mitra42/frugal-iot-hw-sensor/claude-tools/layout/out/render_bottom.png

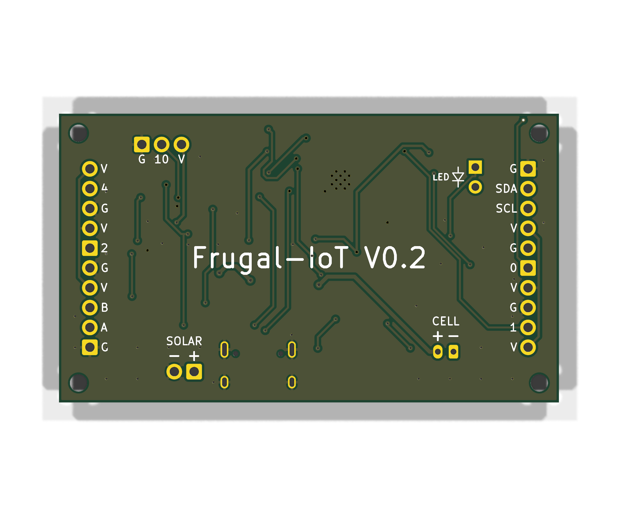
claude-tools/layout/out/render_bottom.png
