mitra42/frugal-iot-hw-sensor/claude-tools/layout/out/render_top.png

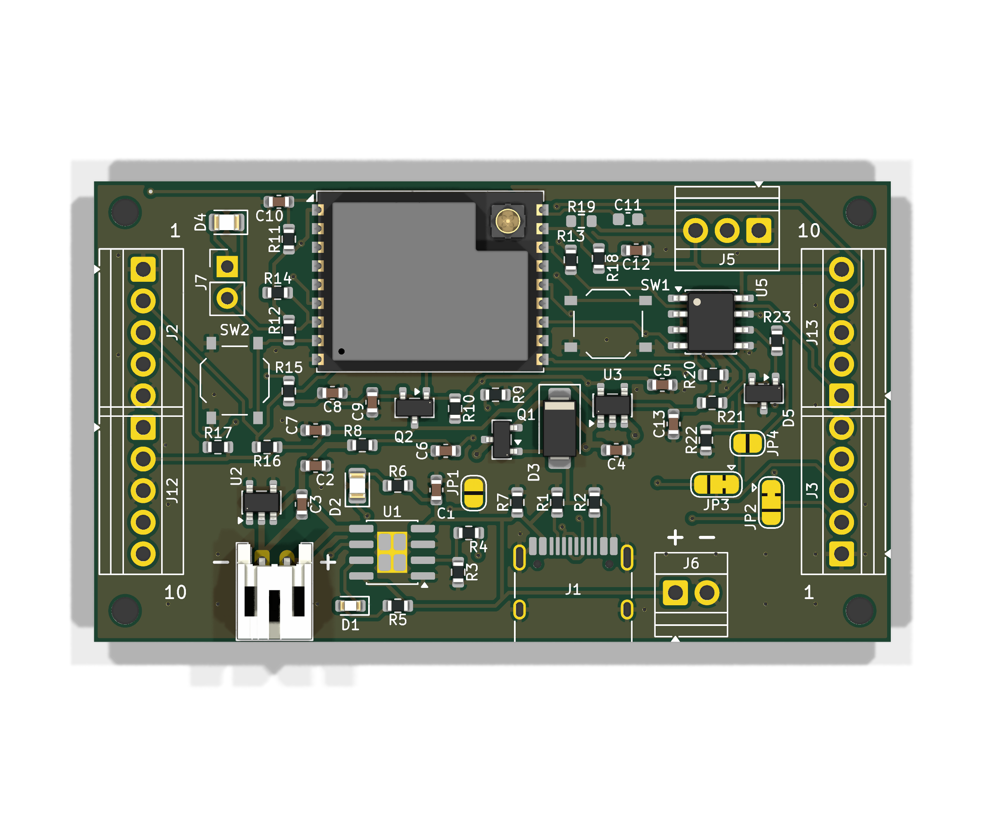
claude-tools/layout/out/render_top.png
