mitra42/frugal-iot-hw-sensor/COST-ESTIMATE.txt

Columns (part table):
  Type    Basic   = JLCPCB Basic part, permanently on a machine feeder: no feeder fee (Economic).
          PrefExt = 'Preferred Extended': Extended, but exempt from the feeder fee on Economic PCBA.
          Ext     = Extended: $3.07 feeder-loading fee once per part number per order (Economic).
  /brd    quantity per board.
  buy@N   quantity JLCPCB buys for N boards = max(/brd x N + JLCPCB's attrition allowance for that part,
          JLCPCB's minimum order for that part). E.g. a 0603 resistor at 10 boards: 1 x 10 + 10 = 20.
  $@N     buy@N x unit price at that quantity's price tier.

Refs                       Value                  LCSC       Type    /brd buy@10    $@10 buy@100   $@100
C1,C2,C4,C5,C8             10uF                   C19702     Basic      5     60    1.27     510    8.31
C3,C6,C9,C12,C13           100nF                  C14663     Basic      5     60    0.49     510    3.21
C7,C10                     1uF                    C15849     Basic      2     30    0.44     210    3.07
D1                         KT-0603R               C2286      Basic      1     20    0.15     110    0.85
D2,D4                      KT-0805G               C2297      Basic      2     30    0.49     210    3.44
D3                         SS34                   C8678      Basic      1     18    0.63     108    3.79
D5                         PSM712-LF-T7           C32677     Basic      1     11    3.79     101   27.57
J1                         TYPE-C-31-M-12         C165948    Ext        1     10    1.87     100   14.78
J2,J3,J12,J13              XY308-2.54-5P          C915914    Ext        4     40   18.21     400  159.84
J4                         S2B-PH-K-S             C173752    Ext        1     10    0.40     100    3.97
J6                         XY308-2.54-2P          C557685    Ext        1     10    2.48     100   19.54
Q1,Q2                      AO3401A                C15127     Basic      2     24    2.30     204   14.12
R1,R2                      5.1k                   C23186     Basic      2     30    0.04     210    0.32
R3,R4,R16-R18              4.7k                   C23162     Basic      5     60    0.17     510    1.43
R5,R6,R15                  1k                     C21190     Basic      3     40    0.07     310    0.53
R7,R10                     100k                   C25803     Basic      2     30    0.09     210    0.65
R8,R9                      1M                     C22935     Basic      2     30    0.05     210    0.38
R11-R14,R20                10k                    C25804     Basic      5     60    0.11     510    0.92
R21,R22                    680R                   C23228     Basic      2     30    0.06     210    0.44
R23                        120R                   C22787     Basic      1     20    0.04     110    0.21
SW1,SW2                    TS-1187A-B-A-B         C318884    Basic      2     28    0.58     208    3.33
U1                         TP4056                 C16581     PrefExt    1     10    1.86     100   14.69
U2                         XB5353A                C80628     Ext        1     12    1.06     102    7.12
U3                         ME6211C33M5G-N         C82942     Ext        1     12    0.76     102    5.26
U4                         ESP32-C3-WROOM-02U-N4  C2926676   Ext        1     10   28.41     100  223.38
U5                         SP3485EN-L/TR          C8963      Basic      1     10    2.64     100   17.63

Per board: 152 SMT joints, 24 through-hole joints, 26 part numbers (7 Extended with fee).

                                             10 Economic 100 Economic, panelised
Setup + stencil + confirm                         $10.16                  $18.37
SMT joints                                         $2.43                  $24.32
Through-hole joints (manual)                       $7.52                  $42.94
Feeder loading                                    $21.49                  $21.49
X-ray (module)                                     $0.00                   $0.00
Fixture + packing                                  $0.00                   $0.00
Components                                        $68.48                 $538.77
Bare PCB (placeholder, see notes)                   $5.00                  $69.90
TOTAL (excl. shipping)                           $115.09                 $715.79
Per board                                         $11.51                   $7.16

Same, per board:
Setup + stencil + confirm                          $1.02                   $0.18
SMT joints                                         $0.24                   $0.24
Through-hole joints (manual)                       $0.75                   $0.43
Feeder loading                                     $2.15                   $0.21
X-ray (module)                                     $0.00                   $0.00
Fixture + packing                                  $0.00                   $0.00
Components                                         $6.85                   $5.39
Bare PCB (placeholder, see notes)                   $0.50                   $0.70
Per board                                         $11.51                   $7.16

Notes:
  * Bare PCB is a placeholder until layout: the irrigation board's JLCPCB quote (100 x 80 mm), an upper bound
    for this 37 mm-high board. Replace with the real quote after layout.
  * Shipping, tax and import duty not included.
  * JLCPCB's FAQ says Economic PCBA above 30 pieces needs panelising; the panel fee ($8.21) is included
    in the 100-board column.
  * No X-ray: the ESP32-C3-WROOM-02U has castellated edge pads (X-ray applies to leadless/BGA parts).
  * Not fitted (DNP) parts cost nothing: J5, J7 and the sensor options R19, C11.
  * J4 (cell JST-PH) and J6 (5 V terminal) are fitted (D34): both Extended, hand-soldered. Together they add
    about $0.97 per board at 10 (mostly two $3.07 feeder fees) and $0.36 at 100.
  * JLCPCB's price page (22 Oct 2026) also lists 'pre-reflow soldering' at $0.016 per joint with no
    explanation; not included here. Check the quote for it.
  * RS485 / Modbus is fitted; leaving it off saves the amount shown at the end (no feeder fees: all Basic
    parts, and J3 is the same part number as J2/J12).

Extended (fee-bearing on Economic): C165948 C915914 C173752 C557685 C80628 C82942 C2926676

RS485 / Modbus (D29): included above. A board without Modbus can leave these off and save:
  parts: C13 100nF, D5 PSM712, J3 J3 RS485 1-5, R20 10k, R21,R22 680R, R23 120R, U5 SP3485EN
   10 boards: components $11.86 + assembly joints $1.16 + feeder fees $0.00 = $13.02  ($1.30 per board)
  100 boards: components $86.90 + assembly joints $11.56 + feeder fees $0.00 = $98.46  ($0.98 per board)
