mitra42/frugal-iot-hw-sensor/claude-tools/layout/out/placement.pdf

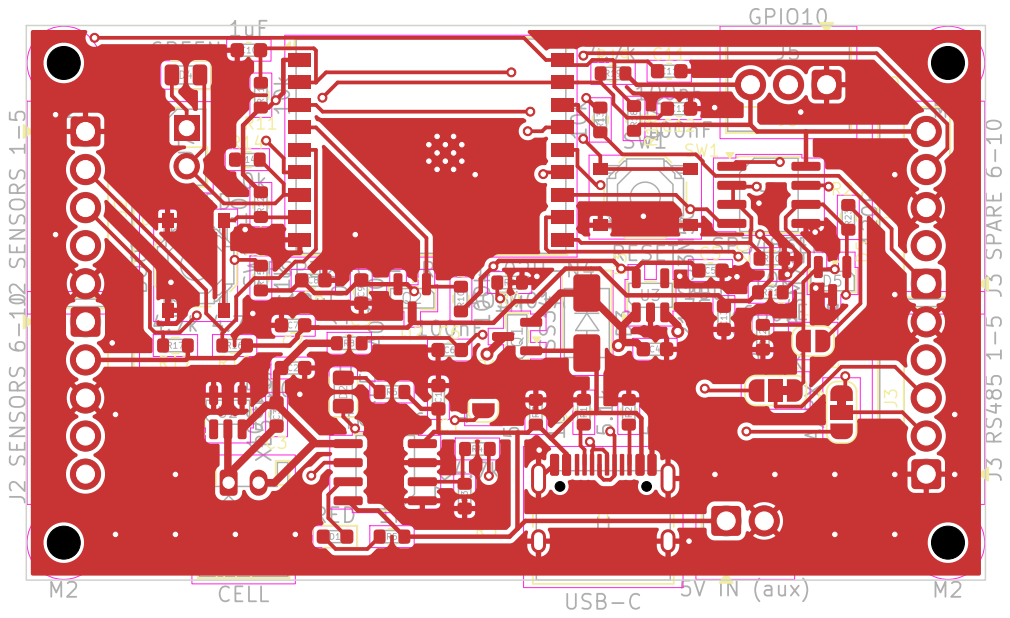
[picture p4: page 1]

Size: A4 | Rev:
KiCad E.D.A. 10.0.4 | Id: 1/1
