mitra42/frugal-iot-hw-sensor/claude-tools/layout/out/copper_bottom.pdf

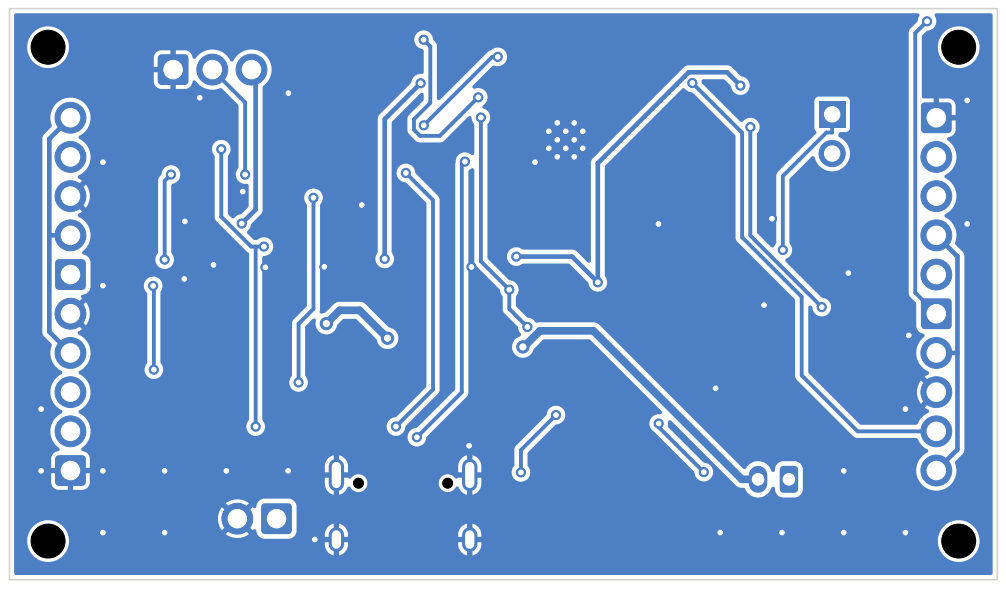
[picture p5: page 1]
