mitra42/frugal-iot-hw-sensor/claude-tools/layout/out/copper_top.pdf

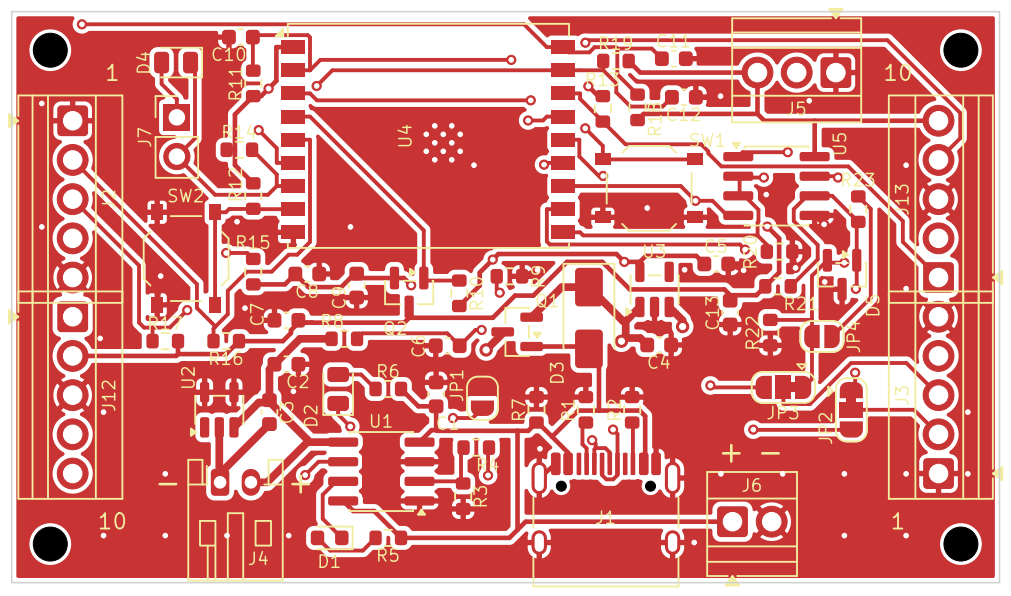
[picture p6: page 1]
