mitra42/frugal-iot-hw-sensor/(list of files, drawings)

Other design files:
claude-tools/layout/out/board.dsn
claude-tools/layout/out/board_r.dsn
