mitra42/frugal-iot-hw-sensor/frugal_iot_v02/frugal_iot_v02.kicad_pcb

## KiCad design frugal_iot_v02/frugal_iot_v02.kicad_pcb (2026-10-30)

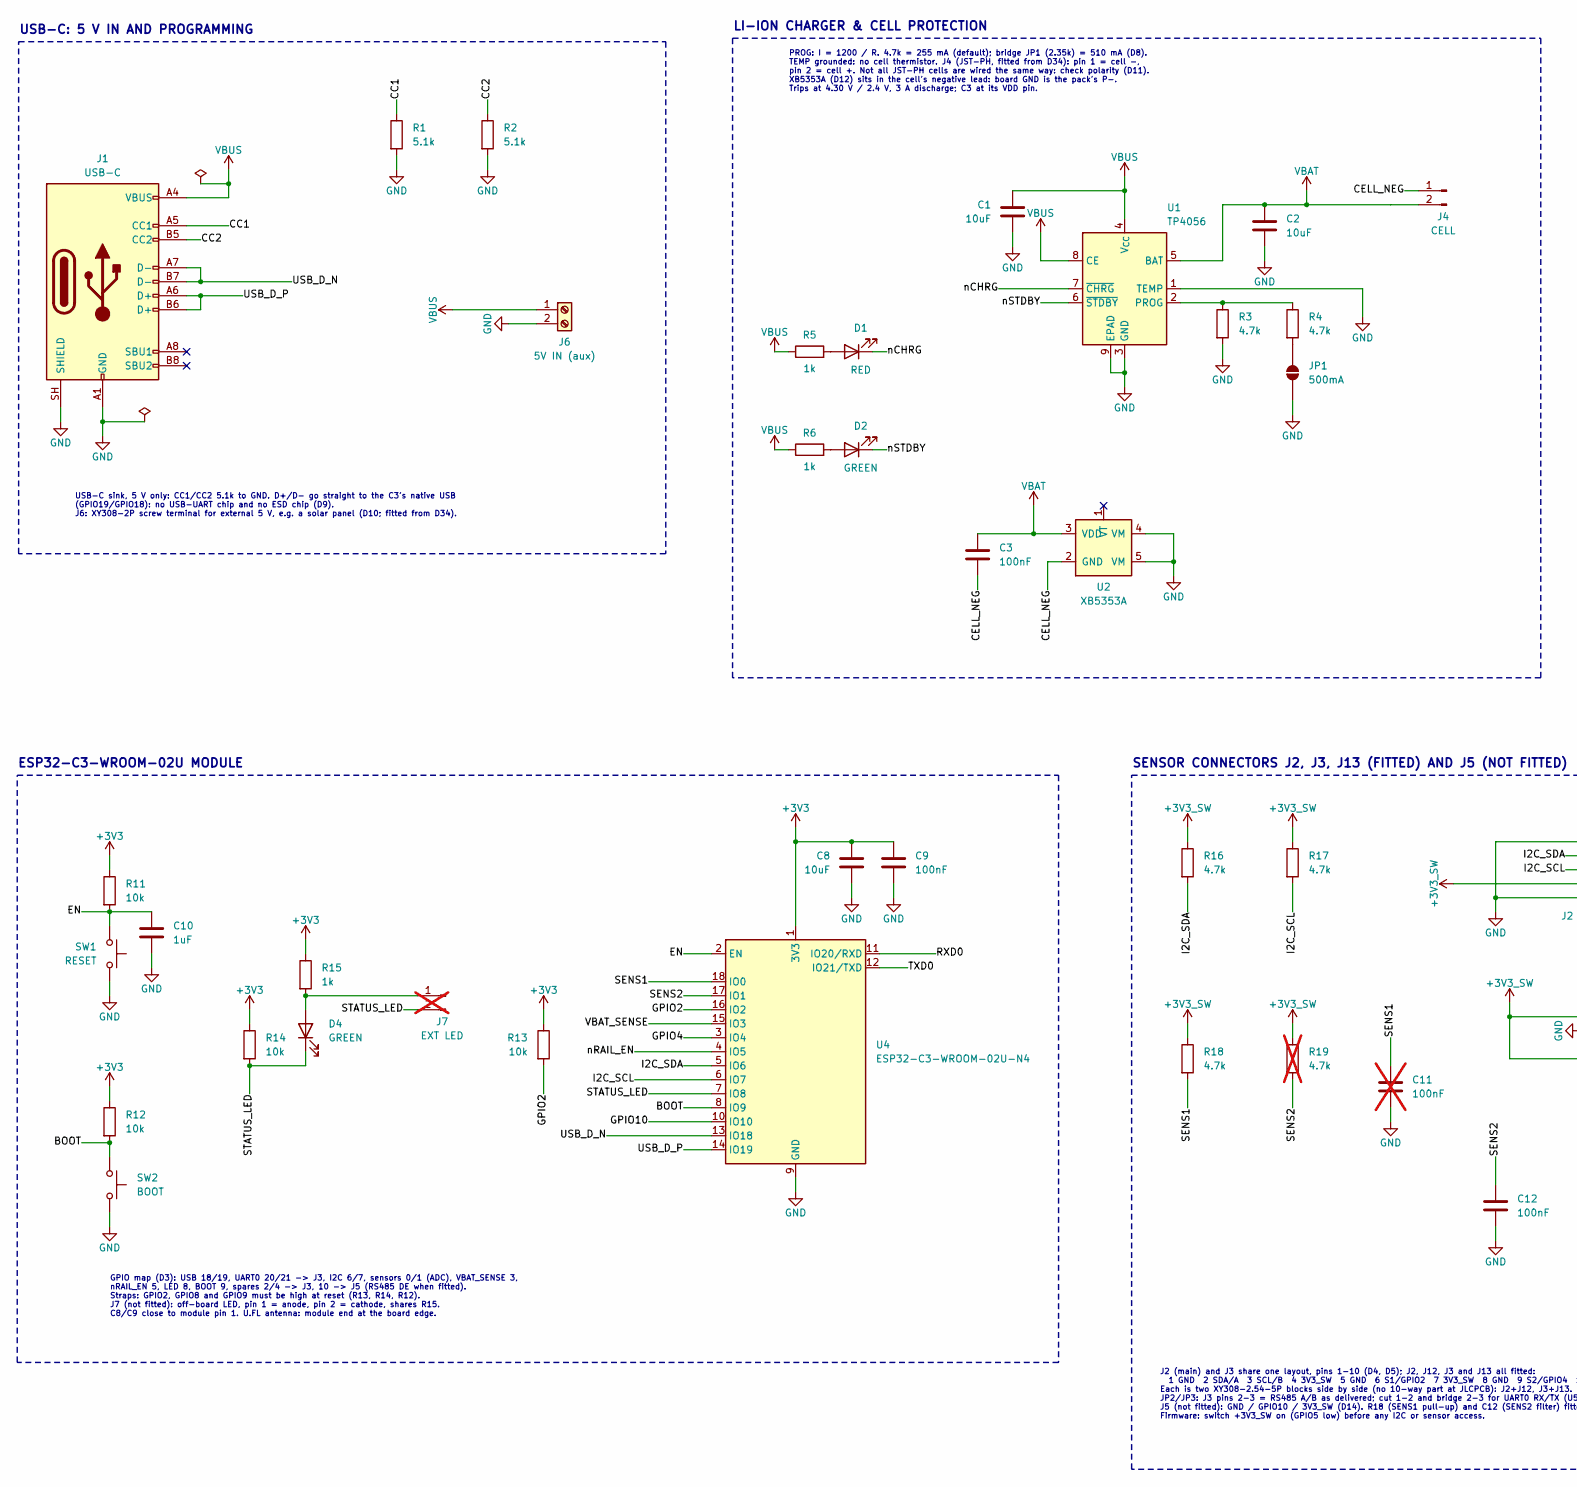
[picture p7: schematic frugal_iot_v02.kicad_sch, Frugal-IoT V0.2, part in row 1, column 1]

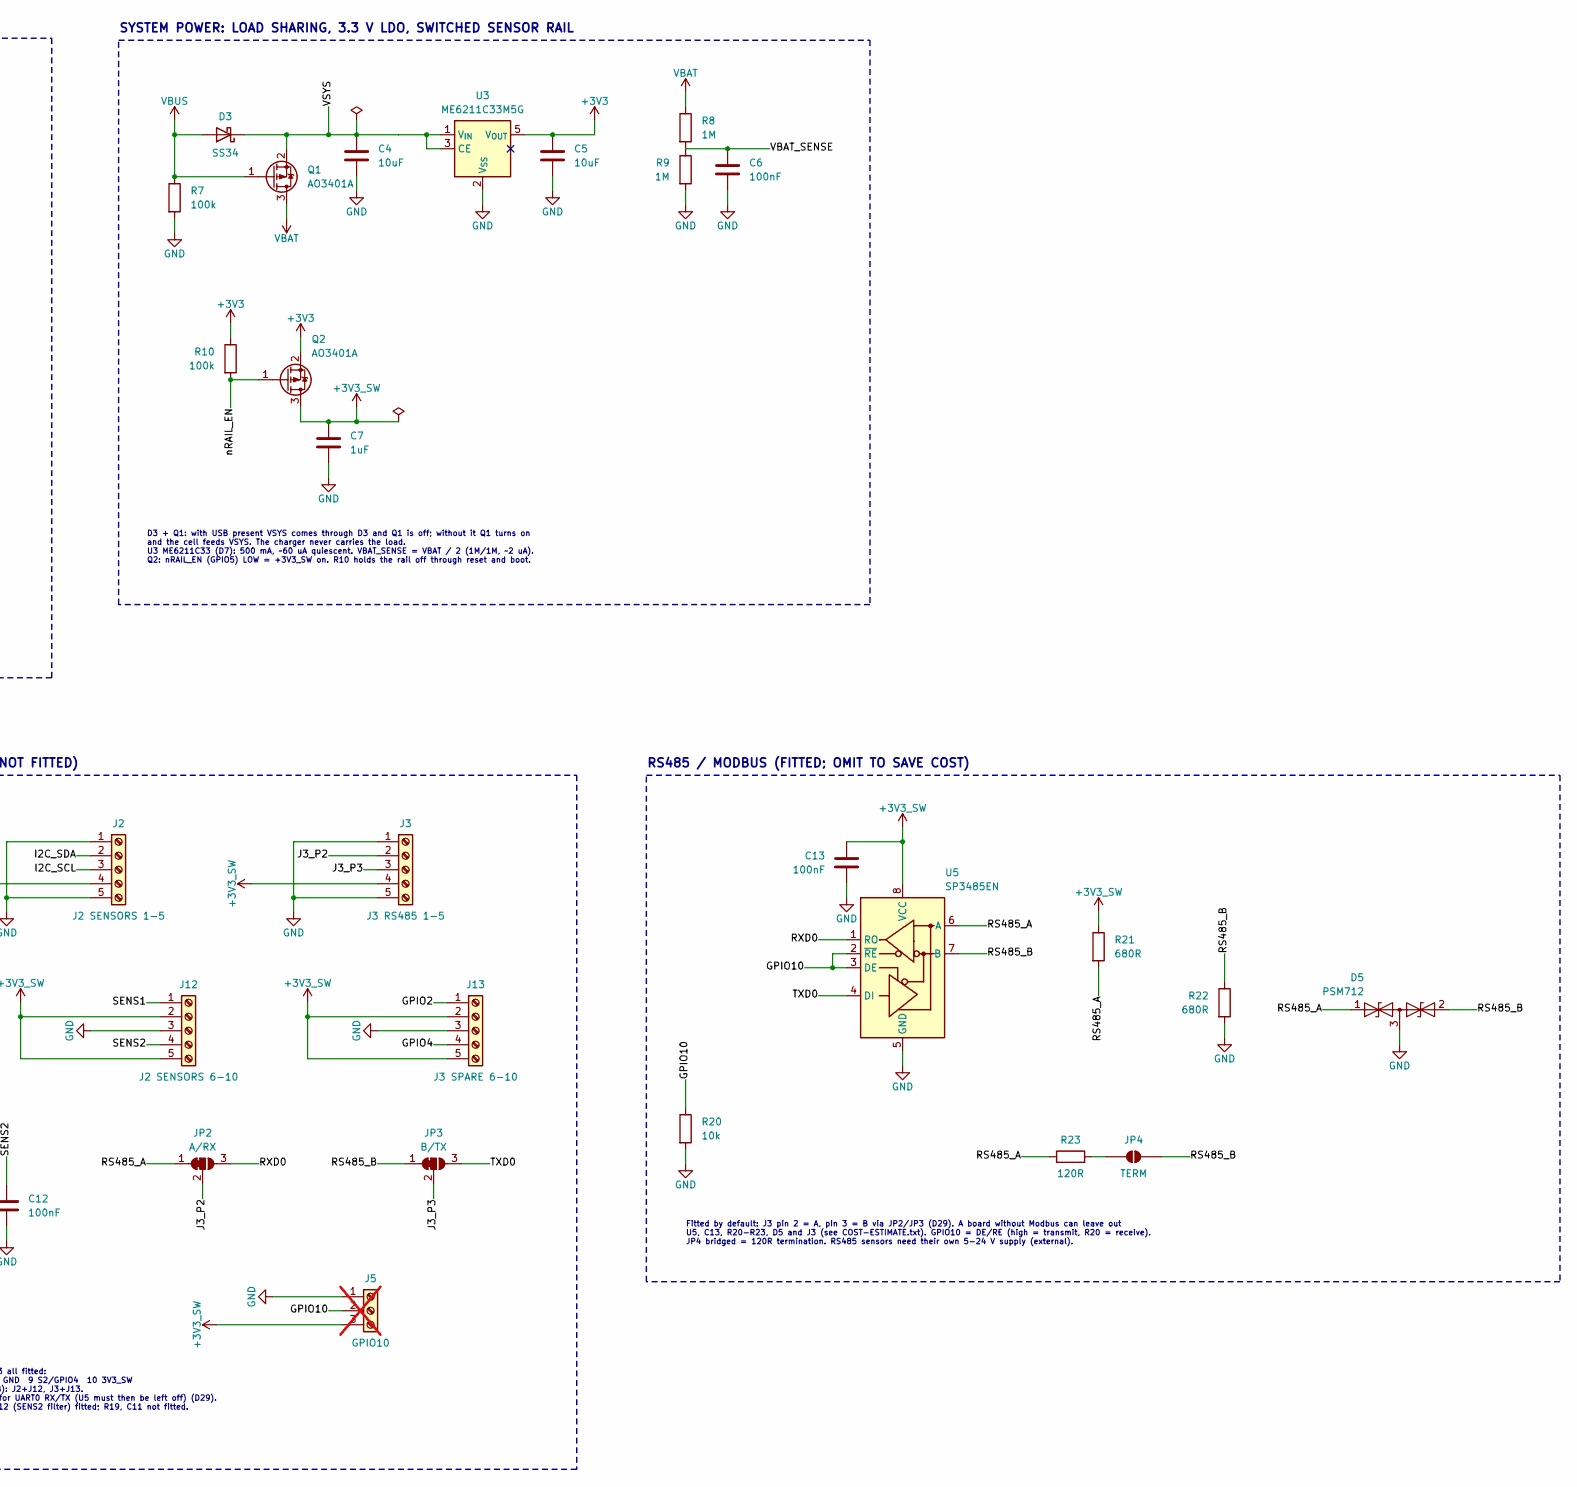
[picture p8: schematic frugal_iot_v02.kicad_sch, Frugal-IoT V0.2, part in row 1, column 2]

Parts:
C1, C2, C4, C5, C8: 10uF; C_0603_1608Metric; MPN 10uF; LCSC C19702
C3, C6, C9, C12, C13: 100nF; C_0603_1608Metric; MPN 100nF; LCSC C14663
C7, C10: 1uF; C_0603_1608Metric; MPN 1uF; LCSC C15849
C11: 100nF; C_0603_1608Metric; MPN 100nF; LCSC C14663; not fitted
D1: RED; LED_0603_1608Metric; MPN KT-0603R; LCSC C2286
D2, D4: GREEN; LED_0805_2012Metric; MPN KT-0805G; LCSC C2297
D3: SS34; D_SMA; MPN SS34; LCSC C8678
D5: PSM712; SOT-23; MPN PSM712-LF-T7; LCSC C32677
J1: USB-C; USB_C_Receptacle_HRO_TYPE-C-31-M-12; MPN TYPE-C-31-M-12; LCSC C165948
J2: J2 SENSORS 1-5; TerminalBlock_Xinya_XY308-2.54-5P_1x05_P2.54mm_Horizontal; MPN XY308-2.54-5P; LCSC C915914
J3: J3 RS485 1-5; TerminalBlock_Xinya_XY308-2.54-5P_1x05_P2.54mm_Horizontal; MPN XY308-2.54-5P; LCSC C915914
J4: CELL; JST_PH_S2B-PH-K_1x02_P2.00mm_Horizontal; MPN S2B-PH-K-S; LCSC C173752
J5: GPIO10; TerminalBlock_Xinya_XY308-2.54-3P_1x03_P2.54mm_Horizontal; MPN XY308-2.54-3P; LCSC C557686; not fitted
J6: 5V IN (aux); TerminalBlock_Xinya_XY308-2.54-2P_1x02_P2.54mm_Horizontal; MPN XY308-2.54-2P; LCSC C557685
J7: EXT LED; PinHeader_1x02_P2.54mm_Vertical; MPN EXT LED; not fitted
J12: J2 SENSORS 6-10; TerminalBlock_Xinya_XY308-2.54-5P_1x05_P2.54mm_Horizontal; MPN XY308-2.54-5P; LCSC C915914
J13: J3 SPARE 6-10; TerminalBlock_Xinya_XY308-2.54-5P_1x05_P2.54mm_Horizontal; MPN XY308-2.54-5P; LCSC C915914
JP1: 500mA; SolderJumper-2_P1.3mm_Open_RoundedPad1.0x1.5mm; MPN 500mA
JP2: A/RX; SolderJumper-3_P1.3mm_Bridged12_RoundedPad1.0x1.5mm; MPN A/RX
JP3: B/TX; SolderJumper-3_P1.3mm_Bridged12_RoundedPad1.0x1.5mm; MPN B/TX
JP4: TERM; SolderJumper-2_P1.3mm_Open_RoundedPad1.0x1.5mm; MPN TERM
Q1, Q2: AO3401A; SOT-23; MPN AO3401A; LCSC C15127
R1, R2: 5.1k; R_0603_1608Metric; MPN 5.1k; LCSC C23186
R3, R4, R16, R17, R18: 4.7k; R_0603_1608Metric; MPN 4.7k; LCSC C23162
R5, R6, R15: 1k; R_0603_1608Metric; MPN 1k; LCSC C21190
R7, R10: 100k; R_0603_1608Metric; MPN 100k; LCSC C25803
R8, R9: 1M; R_0603_1608Metric; MPN 1M; LCSC C22935
R11, R12, R13, R14, R20: 10k; R_0603_1608Metric; MPN 10k; LCSC C25804
R19: 4.7k; R_0603_1608Metric; MPN 4.7k; LCSC C23162; not fitted
R21, R22: 680R; R_0603_1608Metric; MPN 680R; LCSC C23228
R23: 120R; R_0603_1608Metric; MPN 120R; LCSC C22787
SW1: RESET; SW_Push_1P1T_XKB_TS-1187A; MPN TS-1187A-B-A-B; LCSC C318884
SW2: BOOT; SW_Push_1P1T_XKB_TS-1187A; MPN TS-1187A-B-A-B; LCSC C318884
U1: TP4056; SOIC-8-1EP_3.9x4.9mm_P1.27mm_EP2.41x3.3mm; MPN TP4056; LCSC C16581
U2: XB5353A; SOT-23-5; MPN XB5353A; LCSC C80628
U3: ME6211C33M5G; SOT-23-5; MPN ME6211C33M5G-N; LCSC C82942
U4: ESP32-C3-WROOM-02U-N4; ESP32-C3-WROOM-02U; MPN ESP32-C3-WROOM-02U-N4; LCSC C2926676
U5: SP3485EN; SOIC-8_3.9x4.9mm_P1.27mm; MPN SP3485EN-L/TR; LCSC C8963

Connections:
+3V3: C5.1, C8.1, C9.1, Q2.2 (S), R10.1, R11.1, R12.1, R13.1, R14.1, R15.1, U3.5 (V_{OUT}), U4.1 (3V3)
/BOOT: R12.2, SW2.1, U4.8 (IO9)
/CC1: J1.A5 (CC1), R1.1
/CC2: J1.B5 (CC2), R2.1
/CELL_NEG: C3.2, J4.1, U2.2 (GND)
/EN: C10.1, R11.2, SW1.1, U4.2 (EN)
/GPIO2: J13.1, R13.2, U4.16 (IO2)
/GPIO4: J13.4, U4.3 (IO4)
/GPIO10: J5.2, R20.1, U4.10 (IO10), U5.2 (~RE), U5.3 (DE)
/I2C_SCL: J2.3, R17.2, U4.6 (IO7)
/I2C_SDA: J2.2, R16.2, U4.5 (IO6)
/J3_P2: J3.2, JP2.2 (C)
/J3_P3: J3.3, JP3.2 (C)
/RS485_A: D5.1 (A1), JP2.1 (A), R21.2, R23.1, U5.6 (A)
/RS485_B: D5.2 (A2), JP3.1 (A), JP4.2 (B), R22.1, U5.7 (B)
/RXD0: JP2.3 (B), U4.11 (IO20/RXD), U5.1 (RO)
/SENS1: C11.1, J12.1, R18.2, U4.18 (IO0)
/SENS2: C12.1, J12.4, R19.2, U4.17 (IO1)
/STATUS_LED: D4.1 (K), J7.2, R14.2, U4.7 (IO8)
/TXD0: JP3.3 (B), U4.12 (IO21/TXD), U5.4 (DI)
/USB_D_N: J1.A7 (D-), J1.B7 (D-), U4.13 (IO18)
/USB_D_P: J1.A6 (D+), J1.B6 (D+), U4.14 (IO19)
/VBAT_SENSE: C6.1, R8.2, R9.1, U4.15 (IO3)
/nCHRG: D1.1 (K), U1.7 (~CHRG)
/nRAIL_EN: Q2.1 (G), R10.2, U4.4 (IO5)
/nSTDBY: D2.1 (K), U1.6 (~STDBY)
unnamed: D1.2 (A), R5.2
unnamed: D2.2 (A), R6.2
unnamed: D4.2 (A), J7.1, R15.2
unnamed: JP1.1 (A), R4.2
unnamed: JP4.1 (A), R23.2
unnamed: R3.1, R4.1, U1.2 (PROG)
VBAT: C2.1, C3.1, J4.2, Q1.3 (D), R8.1, U1.5 (BAT), U2.3 (VDD)

Notes on the sheet:
D3 + Q1: with USB present VSYS comes through D3 and Q1 is off; without it Q1 turns on and the cell feeds VSYS. The charger never carries the load. U3 ME6211C33 (D7): 500 mA, ~60 uA quiescent. VBAT_SENSE = VBAT / 2 (1M/1M, ~2 uA). Q2: nRAIL_EN (GPIO5) LOW = +3V3_SW on. R10 holds the rail off through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
ESP32-C3-WROOM-02U MODULE
RS485 / MODBUS (FITTED; OMIT TO SAVE COST)
J2 (main) and J3 share one layout, pins 1-10 (D4, D5); J2, J12, J3 and J13 all fitted: 1 GND 2 SDA/A 3 SCL/B 4 3V3_SW 5 GND 6 S1/GPIO2 7 3V3_SW 8 GND 9 S2/GPIO4 10 3V3_SW Each is two XY308-2.54-5P blocks side by side (no 10-way part at JLCPCB): J2+J12, J3+J13. JP2/JP3: J3 pins 2-3 = RS485 A/B as de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
GPIO map (D3): USB 18/19, UART0 20/21 -> J3, I2C 6/7, sensors 0/1 (ADC), VBAT_SENSE 3, nRAIL_EN 5, LED 8, BOOT 9, spares 2/4 -> J3, 10 -> J5 (RS485 DE when fitted). Straps: GPIO2, GPIO8 and GPIO9 must be high at reset (R13, R14, R12). J7 (not fitted): off-board LED, pin 1 = anode, pin 2 = cathode, 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
LI-ION CHARGER & CELL PROTECTION
USB-C sink, 5 V only: CC1/CC2 5.1k to GND. D+/D- go straight to the C3's native USB (GPIO19/GPIO18): no USB-UART chip and no ESD chip (D9). J6: XY308-2P screw terminal for external 5 V, e.g. a solar panel (D10; fitted from D34).
SYSTEM POWER: LOAD SHARING, 3.3 V LDO, SWITCHED SENSOR RAIL
PROG: I = 1200 / R. 4.7k = 255 mA (default); bridge JP1 (2.35k) = 510 mA (D8). TEMP grounded: no cell thermistor. J4 (JST-PH, fitted from D34): pin 1 = cell -, pin 2 = cell +. Not all JST-PH cells are wired the same way: check polarity (D11). XB5353A (D12) sits in the cell's negative lead: board GN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
USB-C: 5 V IN AND PROGRAMMING
Fitted by default: J3 pin 2 = A, pin 3 = B via JP2/JP3 (D29). A board without Modbus can leave out U5, C13, R20-R23, D5 and J3 (see COST-ESTIMATE.txt). GPIO10 = DE/RE (high = transmit, R20 = receive). JP4 bridged = 120R termination. RS485 sensors need their own 5-24 V supply (external).
SENSOR CONNECTORS J2, J3, J13 (FITTED) AND J5 (NOT FITTED)

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
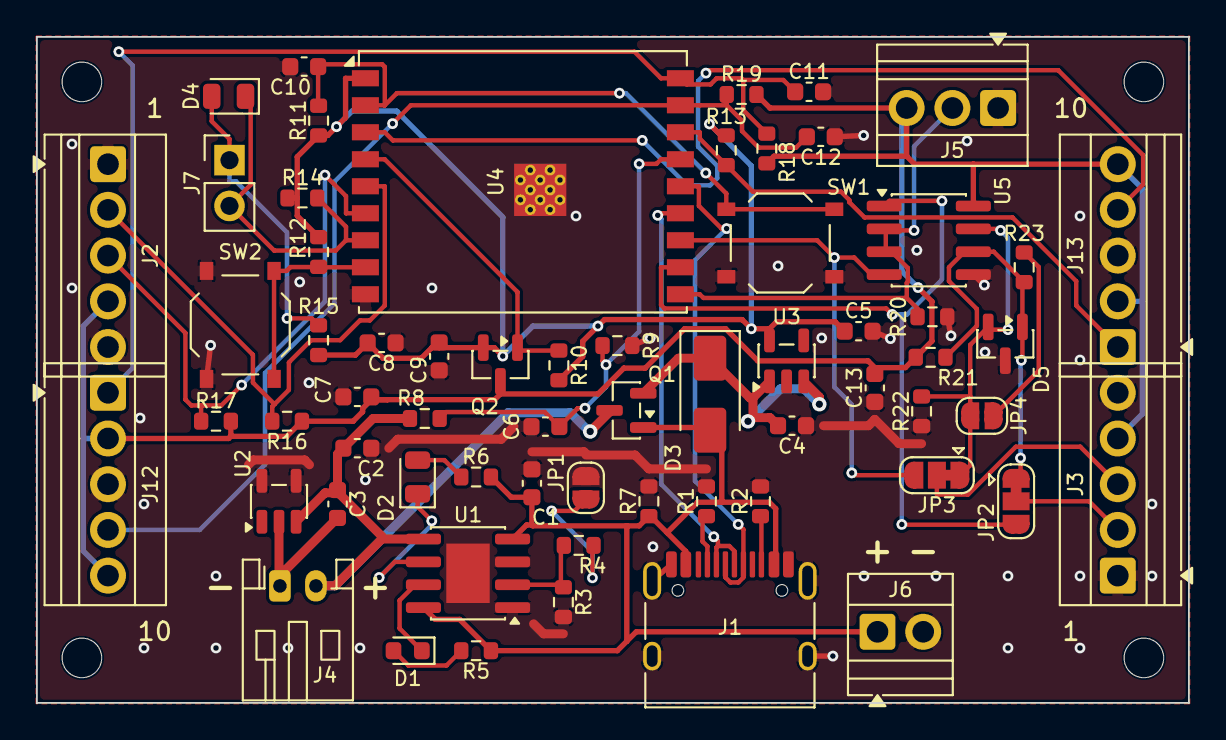
[picture p9: board frugal_iot_v02.kicad_pcb from above]

Board: 2 copper layers, 64.0 x 37.0 mm, 67 parts (0 on the bottom side), 37 nets.

Other parts of the board:
H1, H2, H3, H4: M2; MountingHole_2.2mm_M2
